OB-Ryan/HikingBuddy/tutorial_images/NeoPixel_Board.JPG

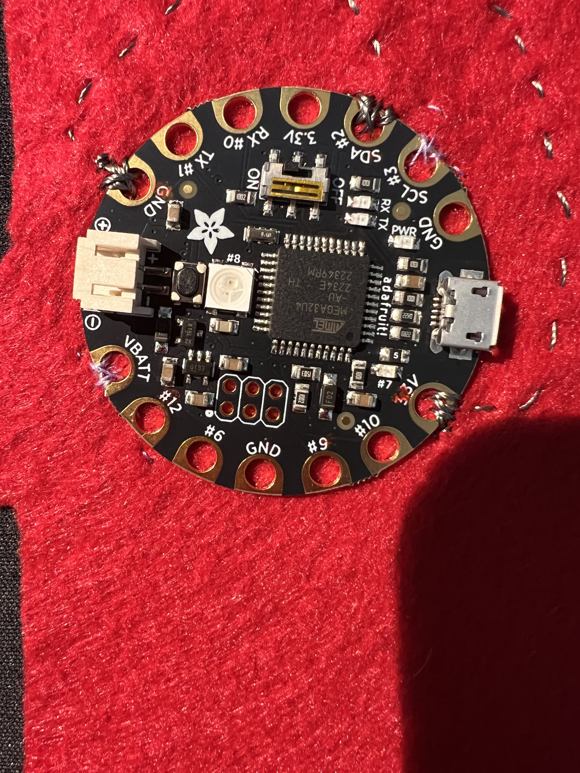
[picture p6: tutorial_images/NeoPixel_Board.JPG]
tutorial_images/NeoPixel_Board.JPG
