OB-Ryan/HikingBuddy/tutorial_images/NeoBack.JPG

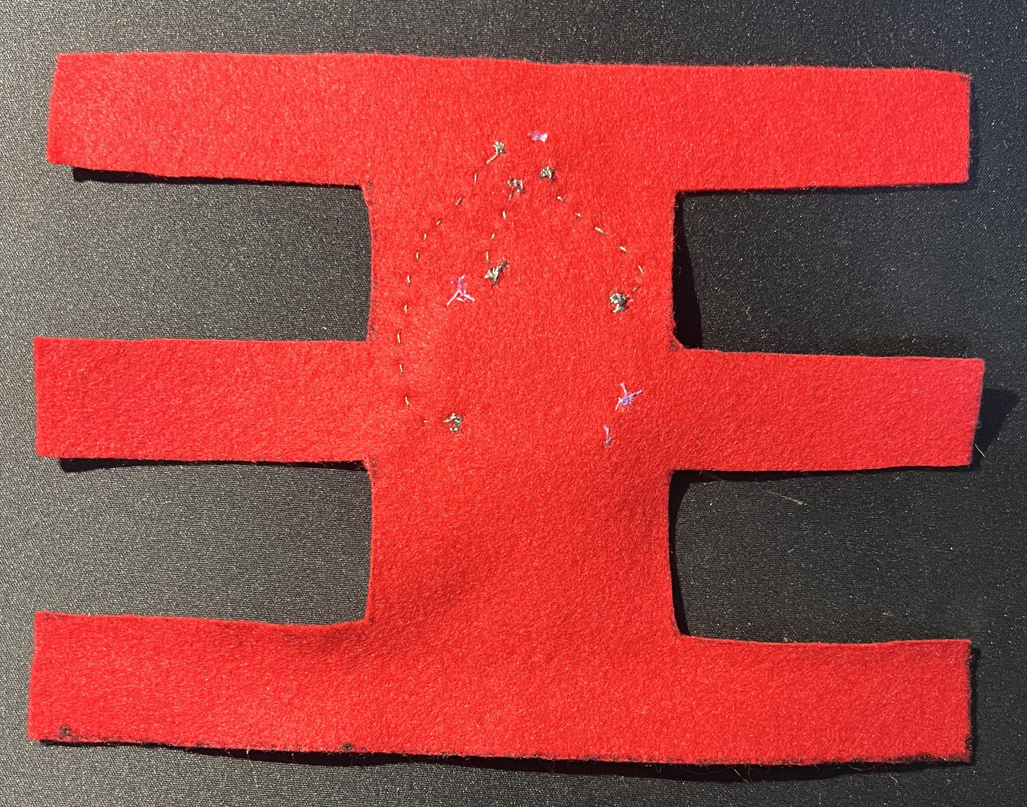
[picture p7: tutorial_images/NeoBack.JPG]
tutorial_images/NeoBack.JPG
