OB-Ryan/HikingBuddy/tutorial_images/tmpLight.JPG

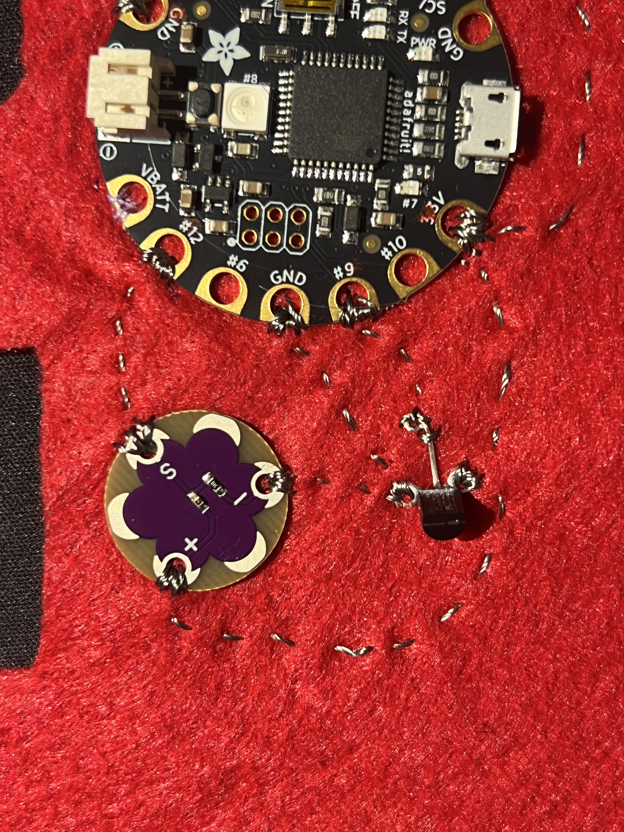
[picture p8: tutorial_images/tmpLight.JPG]
tutorial_images/tmpLight.JPG
