OB-Ryan/HikingBuddy/tutorial_images/FullFrontLarge.JPG

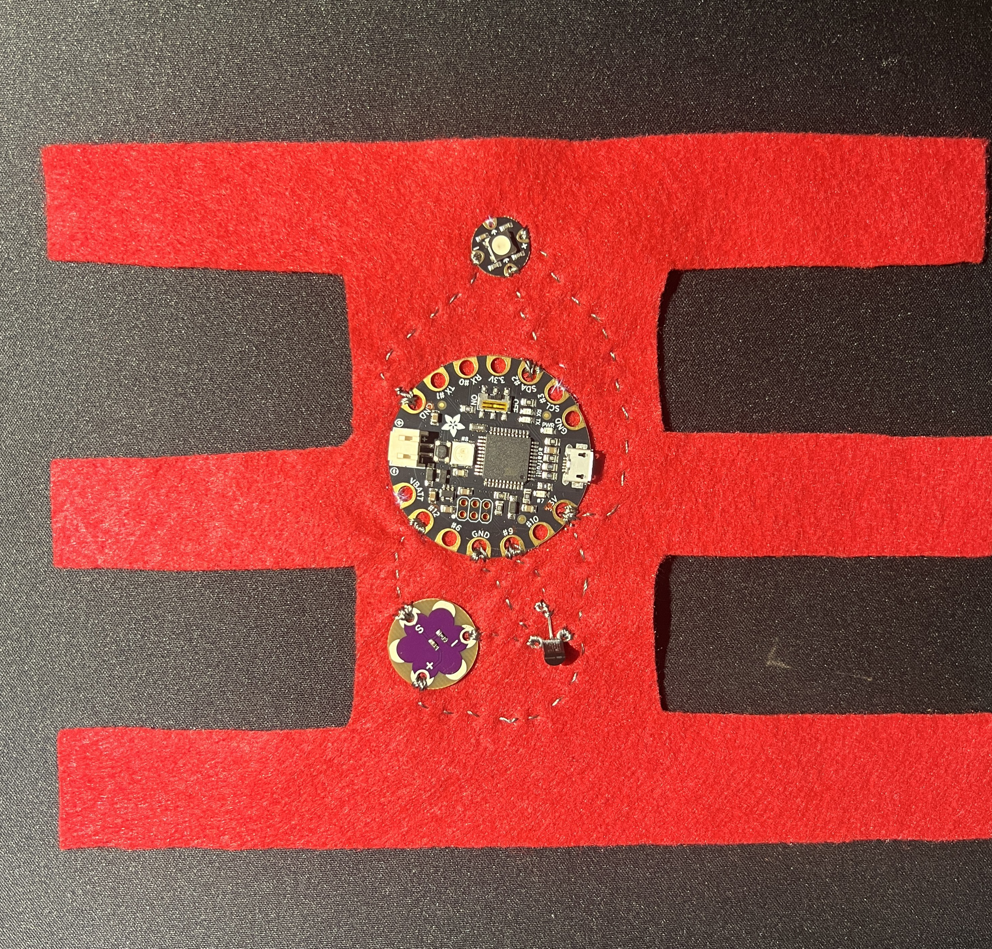
[picture p9: tutorial_images/FullFrontLarge.JPG]
tutorial_images/FullFrontLarge.JPG
