OB-Ryan/HikingBuddy/tutorial_images/Bat1.JPG

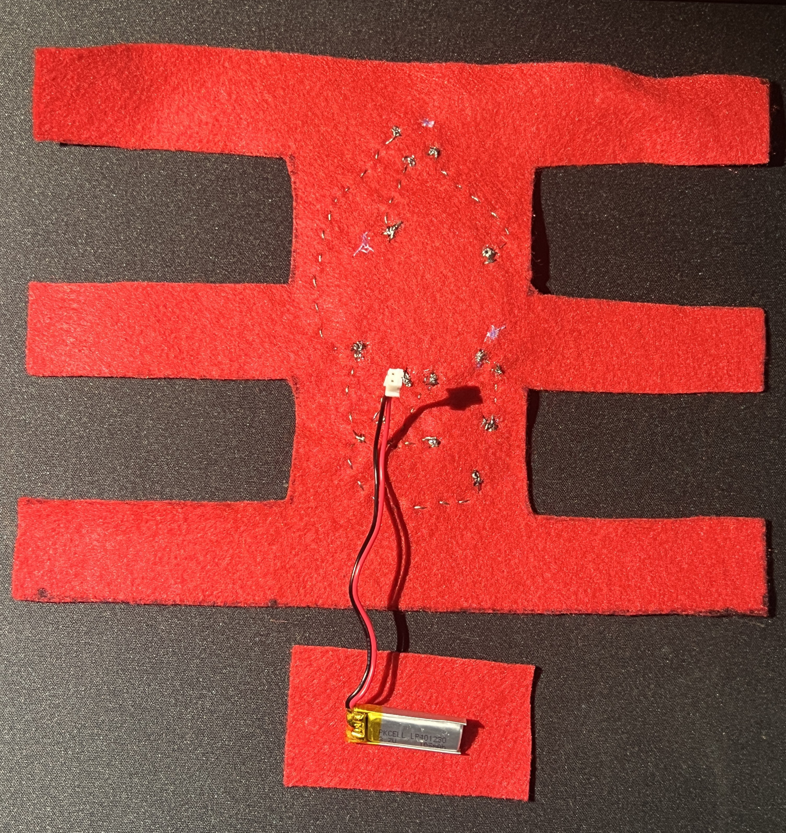
[picture p10: tutorial_images/Bat1.JPG]
tutorial_images/Bat1.JPG
