OB-Ryan/HikingBuddy/tutorial_images/Bat2.JPG

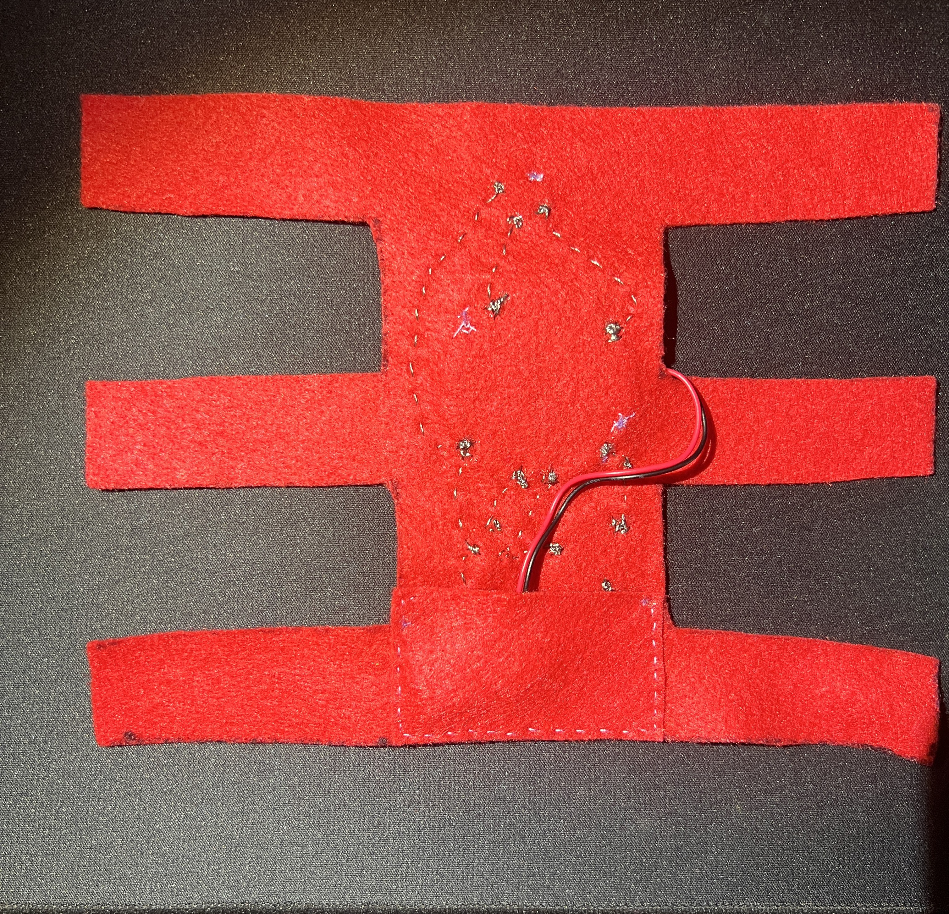
[picture p11: tutorial_images/Bat2.JPG]
tutorial_images/Bat2.JPG
