OB-Ryan/HikingBuddy/tutorial_images/FinishedFront.JPG

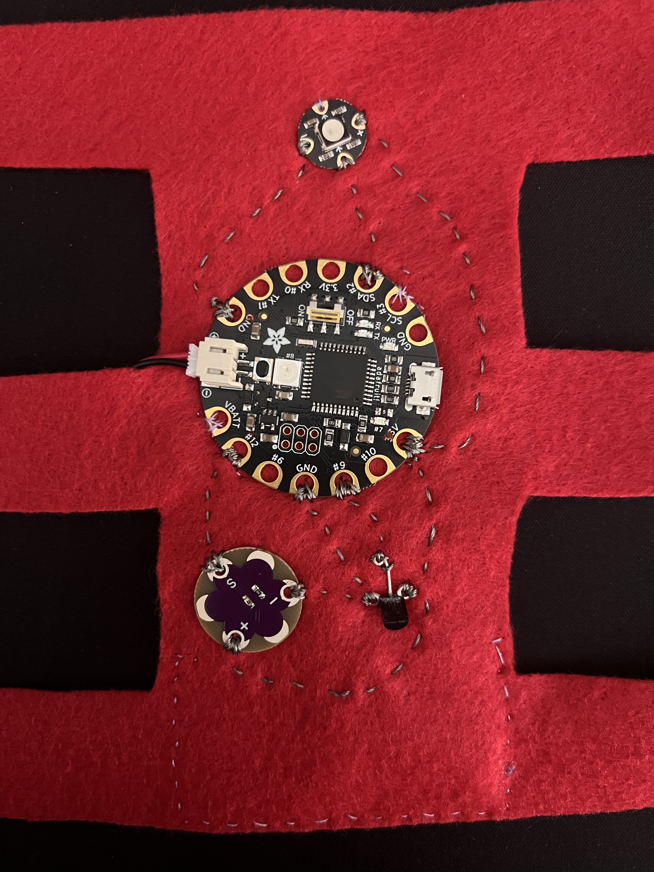
[picture p12: tutorial_images/FinishedFront.JPG]
tutorial_images/FinishedFront.JPG
