OB-Ryan/HikingBuddy/tutorial_images/BackPack.JPG

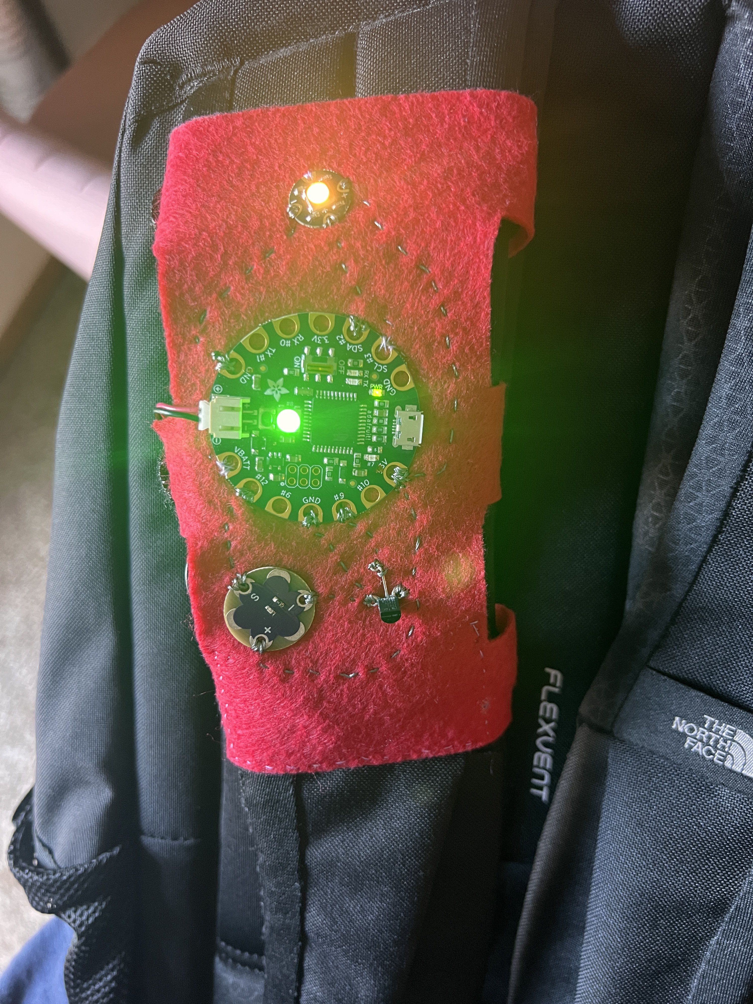
[picture p18: tutorial_images/BackPack.JPG]
tutorial_images/BackPack.JPG
